mikinty/CycleSafe/README.md

# CycleSafe

A safety-system integrated onto you and your bike to keep you safe on the road.

Consists of a smart jacket that is bluetooth integrated with a bike mount.

# Bike

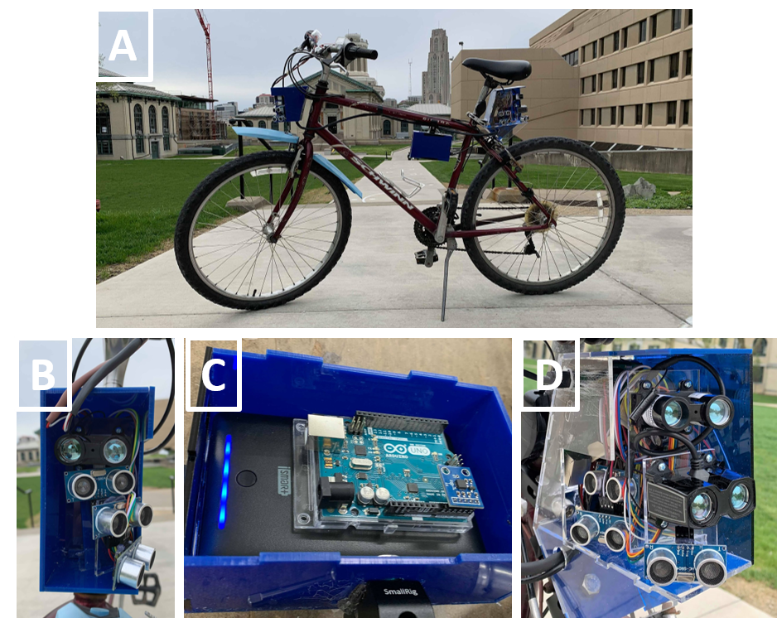
[picture p1: paper/images/bike_mount.png]
Bike Main Photo


Bike view from car
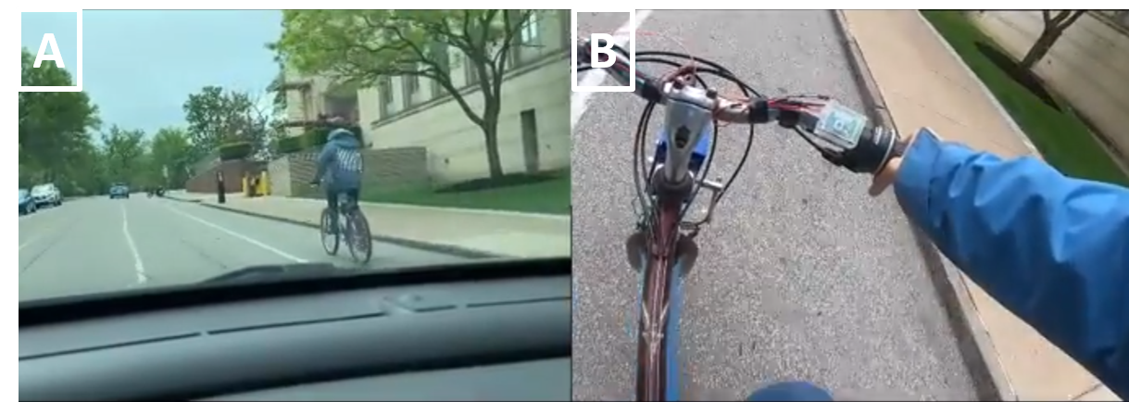
[picture p2: paper/images/side_by.png]
Bike On the Road


Bike visibility
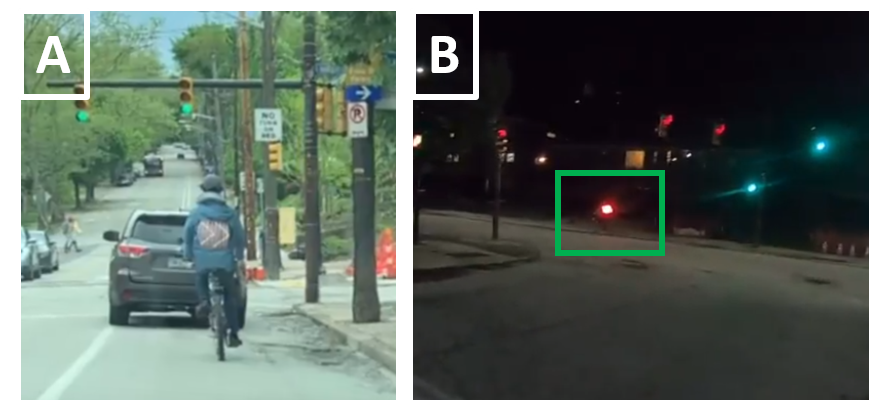
[picture p3: paper/images/visibility.png]
Bike On the Road Night


## Jacket

Chip inside the jacket
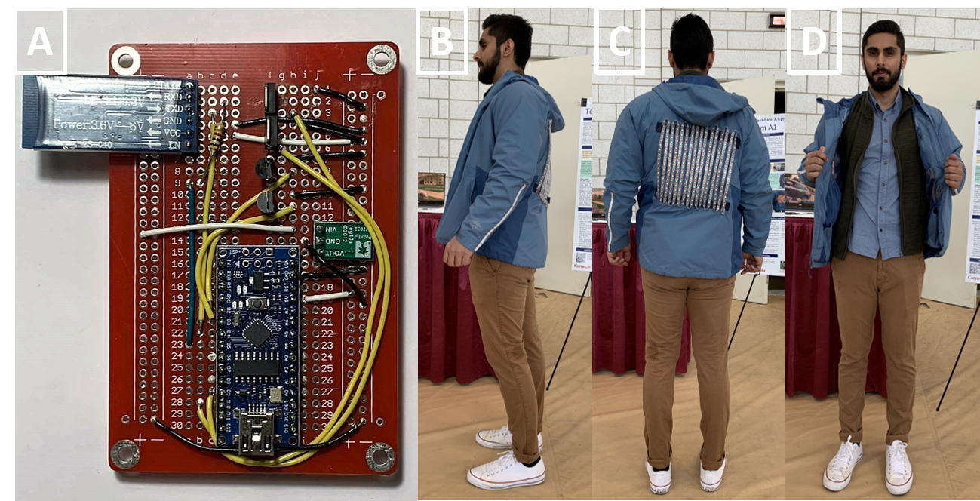
[picture p4: paper/images/jacket_chip.png]
Jacket chip


Turn Signals
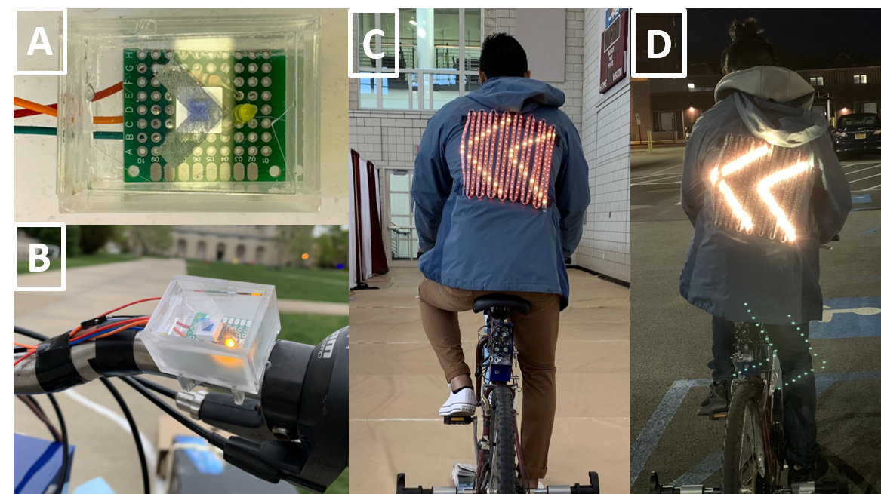
[picture p5: paper/images/turn_signals.png]
Jacket Turn Signal


Buzzer in the jacket to notify the rider
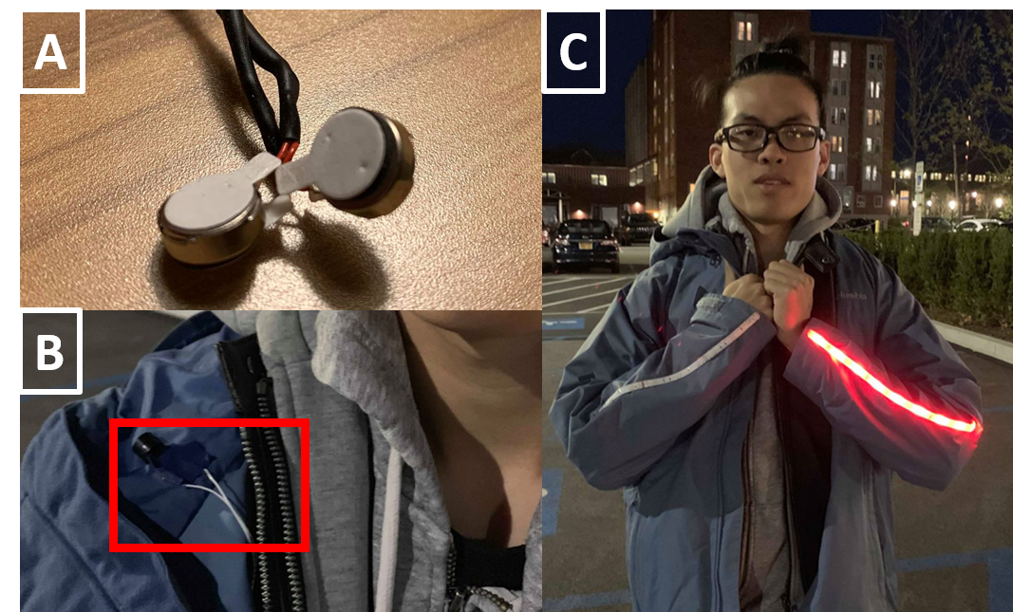
[picture p6: paper/images/buzzer_motor_prox.png]
Jacket Buzzer


## Directory Structure

- `paper`: source code for the paper
- `src`: contains all the code for the project, including

  - `arduino`: modules for the arduino, for sensor and peripheral integration
  - `android`: phone app, uses Google Map data and customizes jacket display
  - `raspberry`: code for the Raspberry Pi controller, safety sensor integration and control center for all operations
