mikinty/CycleSafe/design_review/gantt.pdf

27 | 3 | 10 | 17 | 24 | 3 | 10 | 17 | 24 | 31 | 7 | 14 | 21 | 28 | 5
1/19 | 2/19 | 3/19 | 4/19 | 5/19
CycleSafe | 0h | 50%
Foundations | 0h | 100%
Order Parts | 0 | 100%
Pi - Arduino Architecture | 0 | 100%
Android App Setup | 0 | 100%
Phone App | 0h | 48%
Intersection API Setup | 0 | 100%
Google Maps Intersection Detection | 0 | 90%
Bluetooth communication w/pi | 0 | 50%
Jacket customization settings screen | 0 | 0%
UI Design for App Interface | 0 | 0%
Raspberry Pi | 0h | 70%
Interrupt handling system | 0 | 75%
Sensor integration | 0 | 100%
Peripheral integration | 0 | 0%
Phone integration | 0 | 0%
Garmin LIDAR communication | 0 | 100%
Ultrasonic Sensor communication | 0 | 100%
Sensors | 0h | 82%
Garmin LIDAR 40m | 0 | 100%
Ultrasonic Sensor | 0 | 100%
Hall Effect/Speedometer | 0 | 100%
Equations/Specs for Safety | 0 | 100%
Bike Construction | 0 | 0%
Peripherals | 0h | 60%
16x16 LED Matrix | 0 | 75%
LED Matrix Cloth Support | 0 | 0%
Piezo Buzzers trigger | 0 | 100%
Vibration Motors trigger | 0 | 100%
Arduino Integration with Components | 0 | 100%
Arduino Bluetooth with RPi | 0 | 100%
Jacket construction with components... | 0 | 0%
Testing | 0h | 0%
Arduino Sensor Tests | 0 | 0%
Android Unit Tests | 0 | 0%
Intersection detection | 0 | 0%
Turn signal control | 0 | 0%
Collision detection | 0 | 0%
Case 1 | 0 | 0%
Case 2 | 0 | 0%
Case 3 | 0 | 0%
Architecture | 0h | 82%
Communication protocol | 0 | 50%
Component wiring design | 0 | 100%
Physical Wiring of Jacket | 0 | 100%
Git repo arch | 0 | 100%
Presentations | 0h | 27%
Proposal | 0 | 100%
Mid-Semester Review | 0 | 100%
Mid-Semester Paper | 0 | 50%
Final Poster | 0 | 0%
Demo | 0 | 0%
Final Paper | 0 | 0%
Other | 0h | 0%
Slack | 0 | 0%

Ben Huang, Michael You, Sid Lathar Ben Huang, Michael You, Sid Lathar Sid Lathar

Sid Lathar
Sid Lathar
Sid Lathar
Sid Lathar
Sid Lathar

Ben Huang
Ben Huang
Ben Huang, Michael You
Ben Huang
Ben Huang
Ben Huang

Ben Huang, Michael You
Ben Huang, Michael You
Ben Huang, Michael You
Ben Huang
Ben Huang, Michael You

Michael You
Michael You
Michael You
Michael You
Michael You
Michael You
Michael You

Michael You
Sid Lathar
Ben Huang, Michael You, Sid Lathar
Ben Huang, Michael You, Sid Lathar
Ben Huang, Michael You, Sid Lathar
Ben Huang, Michael You, Sid Lathar Ben Huang, Michael You, Sid Lathar Ben Huang, Michael You, Sid Lathar

Ben Huang, Michael You, Sid Lathar Michael You
Michael You
Michael You

Ben Huang, Michael You, Sid Lathar Ben Huang, Michael You, Sid Lathar

Ben Huang, Michael You, Sid Lathar Ben Huang, Michael You, Sid Lathar Ben Huang, Michael You, Sid Lathar

Ben Huang, Michael You, Sid Lathar

Powered by TCPDF (www.tcpdf.org)
