mikinty/CycleSafe/design_review/preamble.tex

%% Packages for paper
\usepackage{cite}

% *** GRAPHICS RELATED PACKAGES ***
\usepackage[pdftex]{graphicx}
\graphicspath{{images/}}
\DeclareGraphicsExtensions{.pdf,.jpeg,.png}
\usepackage{tikz}
\usepackage[american voltages, arrowmos]{circuitikz}
\usetikzlibrary{math}

% *** MATH PACKAGES ***
\usepackage{amsmath}
\usepackage{physics}
\usepackage{siunitx}

% *** SPECIALIZED LIST PACKAGES ***
\usepackage{algorithmic}

% *** SUBFIGURE PACKAGES ***
\usepackage[caption=false,font=footnotesize]{subfig}

% *** FLOAT PACKAGES ***
\usepackage{float}
%\usepackage{fixltx2e}
% fixltx2e, the successor to the earlier fix2col.sty, was written by
% Frank Mittelbach and David Carlisle. This package corrects a few problems
% in the LaTeX2e kernel, the most notable of which is that in current
% LaTeX2e releases, the ordering of single and double column floats is not
% guaranteed to be preserved. Thus, an unpatched LaTeX2e can allow a
% single column figure to be placed prior to an earlier double column
% figure.
% Be aware that LaTeX2e kernels dated 2015 and later have fixltx2e.sty's
% corrections already built into the system in which case a warning will
% be issued if an attempt is made to load fixltx2e.sty as it is no longer
% needed.
% The latest version and documentation can be found at:
% http://www.ctan.org/pkg/fixltx2e

%\usepackage{stfloats}
% stfloats.sty was written by Sigitas Tolusis. This package gives LaTeX2e
% the ability to do double column floats at the bottom of the page as well
% as the top. (e.g., "\begin{figure*}[!b]" is not normally possible in
% LaTeX2e). It also provides a command:
%\fnbelowfloat
% to enable the placement of footnotes below bottom floats (the standard
% LaTeX2e kernel puts them above bottom floats). This is an invasive package
% which rewrites many portions of the LaTeX2e float routines. It may not work
% with other packages that modify the LaTeX2e float routines. The latest
% version and documentation can be obtained at:
% http://www.ctan.org/pkg/stfloats
% Do not use the stfloats baselinefloat ability as the IEEE does not allow
% \baselineskip to stretch. Authors submitting work to the IEEE should note
% that the IEEE rarely uses double column equations and that authors should try
% to avoid such use. Do not be tempted to use the cuted.sty or midfloat.sty
% packages (also by Sigitas Tolusis) as the IEEE does not format its papers in
% such ways.
% Do not attempt to use stfloats with fixltx2e as they are incompatible.
% Instead, use Morten Hogholm'a dblfloatfix which combines the features
% of both fixltx2e and stfloats:
%
% \usepackage{dblfloatfix}
% The latest version can be found at:
% http://www.ctan.org/pkg/dblfloatfix

%\ifCLASSOPTIONcaptionsoff
%  \usepackage[nomarkers]{endfloat}
% \let\MYoriglatexcaption\caption
% \renewcommand{\caption}[2][\relax]{\MYoriglatexcaption[#2]{#2}}
%\fi
% endfloat.sty was written by James Darrell McCauley, Jeff Goldberg and 
% Axel Sommerfeldt. This package may be useful when used in conjunction with 
% IEEEtran.cls'  captionsoff option. Some IEEE journals/societies require that
% submissions have lists of figures/tables at the end of the paper and that
% figures/tables without any captions are placed on a page by themselves at
% the end of the document. If needed, the draftcls IEEEtran class option or
% \CLASSINPUTbaselinestretch interface can be used to increase the line
% spacing as well. Be sure and use the nomarkers option of endfloat to
% prevent endfloat from "marking" where the figures would have been placed
% in the text. The two hack lines of code above are a slight modification of
% that suggested by in the endfloat docs (section 8.4.1) to ensure that
% the full captions always appear in the list of figures/tables - even if
% the user used the short optional argument of \caption[]{}.
% IEEE papers do not typically make use of \caption[]'s optional argument,
% so this should not be an issue. A similar trick can be used to disable
% captions of packages such as subfig.sty that lack options to turn off
% the subcaptions:
% For subfig.sty:
% \let\MYorigsubfloat\subfloat
% \renewcommand{\subfloat}[2][\relax]{\MYorigsubfloat[]{#2}}
% However, the above trick will not work if both optional arguments of
% the \subfloat command are used. Furthermore, there needs to be a
% description of each subfigure *somewhere* and endfloat does not add
% subfigure captions to its list of figures. Thus, the best approach is to
% avoid the use of subfigure captions (many IEEE journals avoid them anyway)
% and instead reference/explain all the subfigures within the main caption.
% The latest version of endfloat.sty and its documentation can obtained at:
% http://www.ctan.org/pkg/endfloat
%
% The IEEEtran \ifCLASSOPTIONcaptionsoff conditional can also be used
% later in the document, say, to conditionally put the References on a 
% page by themselves.

% *** PDF, URL AND HYPERLINK PACKAGES ***
\usepackage{url}
\usepackage{hyperref}
\hypersetup{
    urlcolor=blue
}

% *** OTHER PACKAGESS ***
\usepackage{booktabs} % for \toprule, \midrule, etc
\usepackage{tabularx}
\usepackage{pdfpages}

% correct bad hyphenation here
\hyphenation{op-tical net-works semi-conduc-tor}

%% Shortcuts
\newcommand{\slane}{s_\text{lane}}
\newcommand{\sbrake}{s_\text{brake}}
\newcommand{\lidar}{Garmin LIDAR-Lite v3}
\newcommand{\sonar}{HC-SR04}

%% Custom config
\DeclareSIUnit{\mph}{mph}
\DeclareSIUnit\lb{lb}
\sisetup{detect-all} % Use the environment font when calling siunitx
