mikinty/CycleSafe/design_review/images/speedometer.png

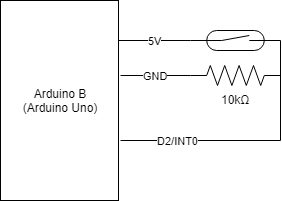
design_review/images/speedometer.png
