mikinty/CycleSafe/paper/images/BS_Overall.PNG

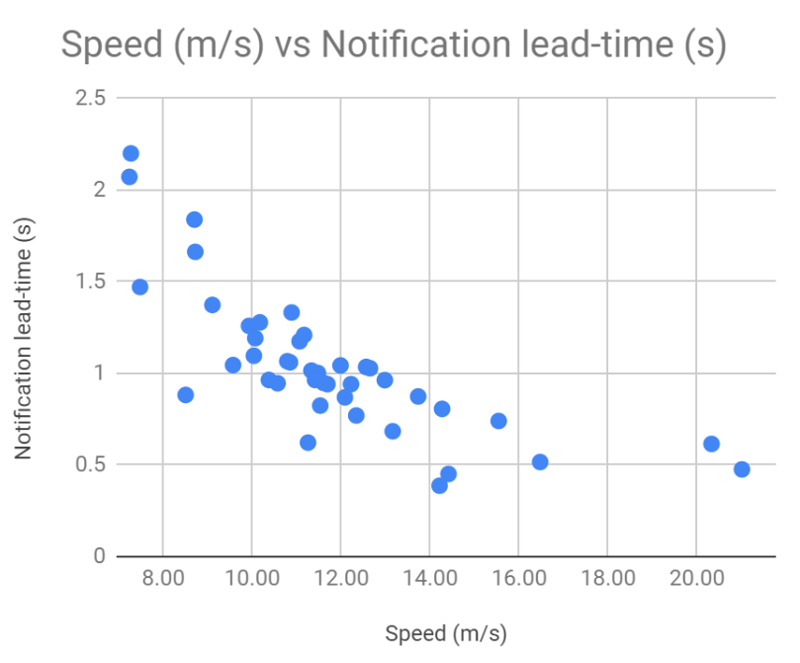
paper/images/BS_Overall.PNG
