mikinty/CycleSafe/models/side_assembly.SLDASM

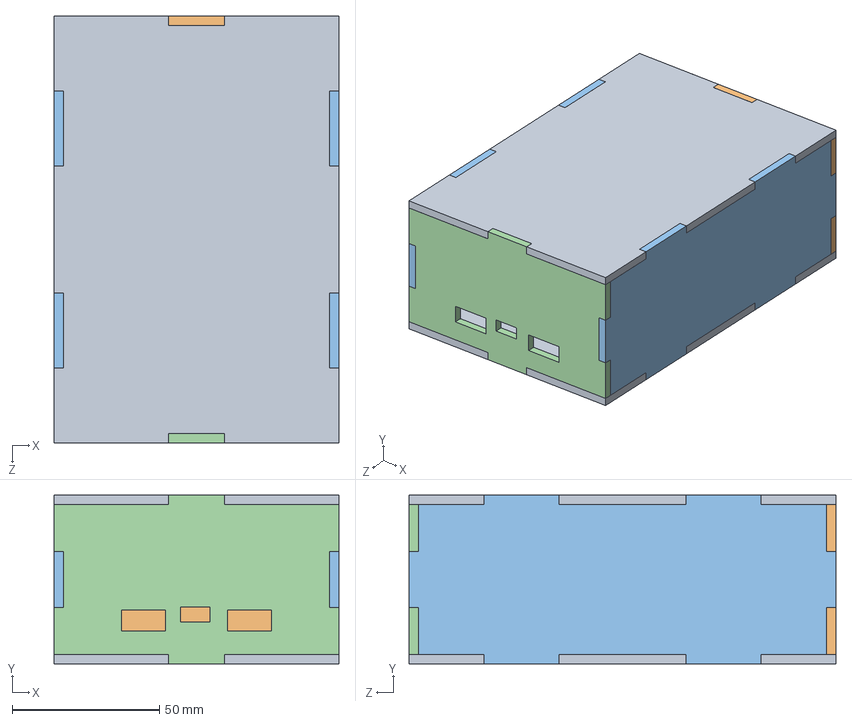
[picture p21: CAD file, 2019-05-08]
models/side_assembly.SLDASM
96.5 x 57.2 x 144.8 mm
battery_mount_base x 2
battery_mount_side
battery_mount_side_long x 2
battery_mount_side_front
