mikinty/CycleSafe/models/back_assembly.SLDASM

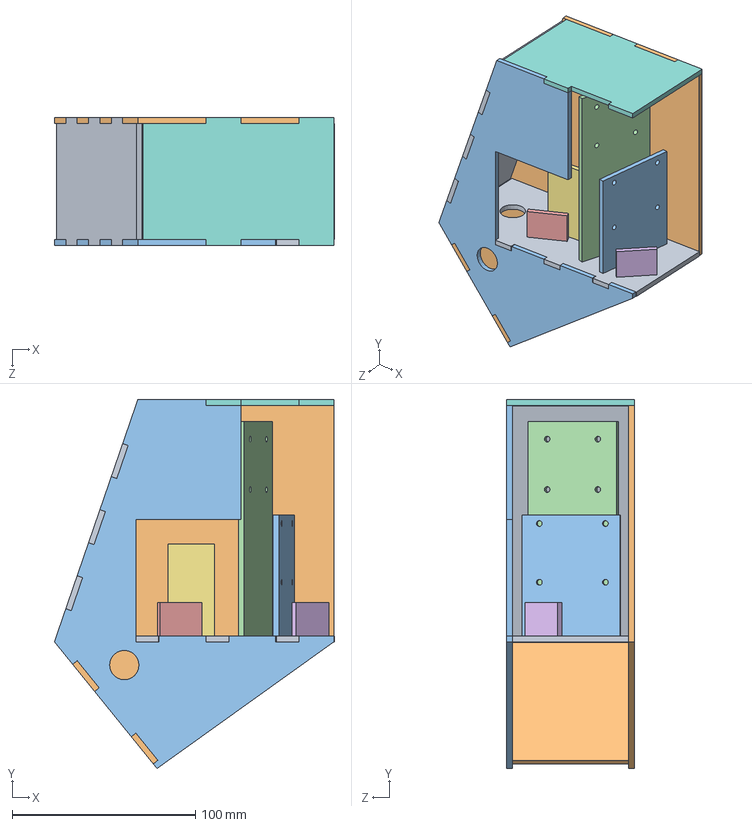
[picture p22: CAD file, 2019-05-08]
models/back_assembly.SLDASM
152.8 x 201.2 x 69.8 mm
back_mount_base
back_mount_cover_back
lidar_back_straight
lidar_back_slant
ultrasound_back_medium
ultrasound_back_short
ultrasound_back_tall
back_mount_roof
back_mount_cover_slant_top
back_mount_cover_slant_bot
back_mount_cover_front
