mikinty/CycleSafe/models/front_assembly.SLDASM

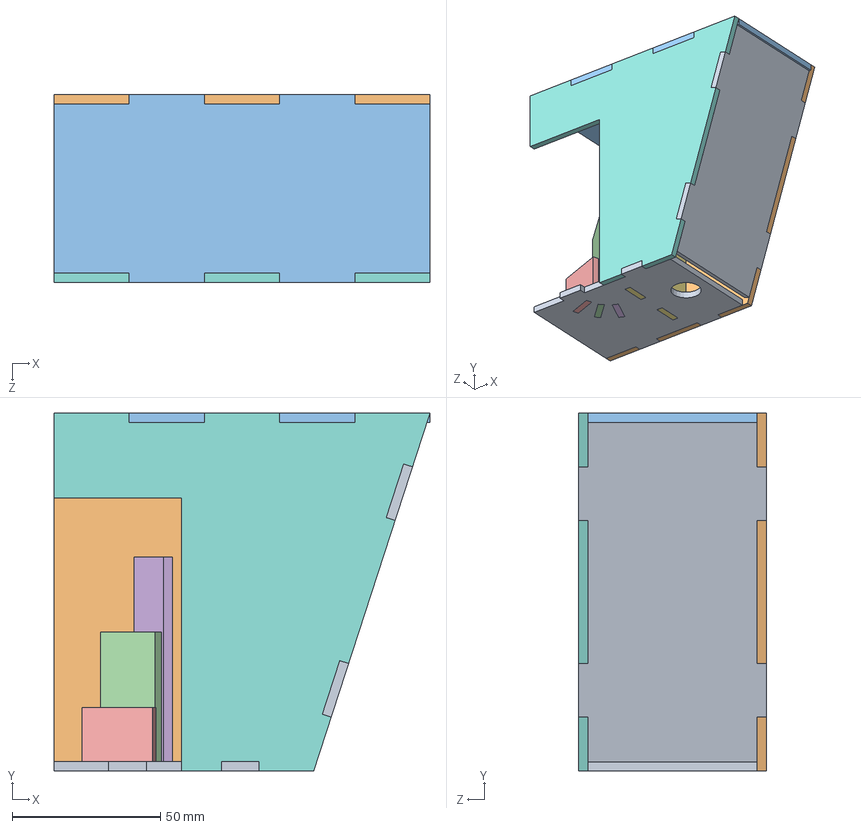
[picture p23: CAD file, 2019-05-08]
models/front_assembly.SLDASM
127.0 x 120.8 x 63.5 mm
front_mount_base
front_mount_cover
front_mount_roof
ultrasound_front_medium
ultrasound_front_short
ultrasound_front_tall
lidar_front
front_mount_cover_front
front_mount_cover_back
