mikinty/CycleSafe/models/turn_sig_assembly.SLDASM

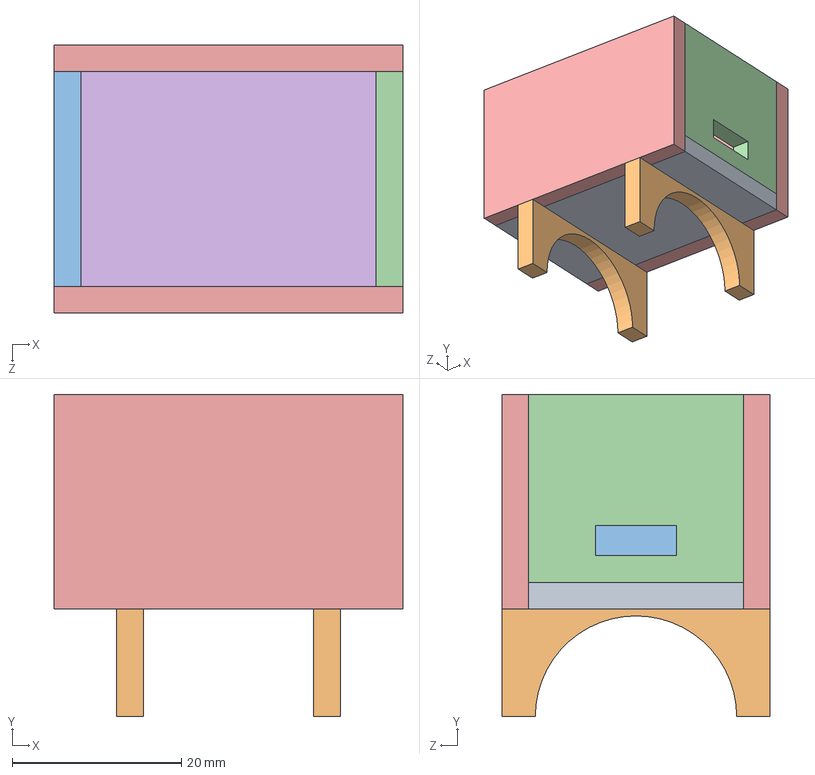
[picture p24: CAD file, 2019-05-08]
models/turn_sig_assembly.SLDASM
41.3 x 38.1 x 31.8 mm
turn_sig_bottom
turn_sig_arch x 2
turn_sig_back
turn_sig_front
turn_sig_side x 2
turn_sig_top
