mikinty/CycleSafe/models/lidar_back_slant.SLDPRT

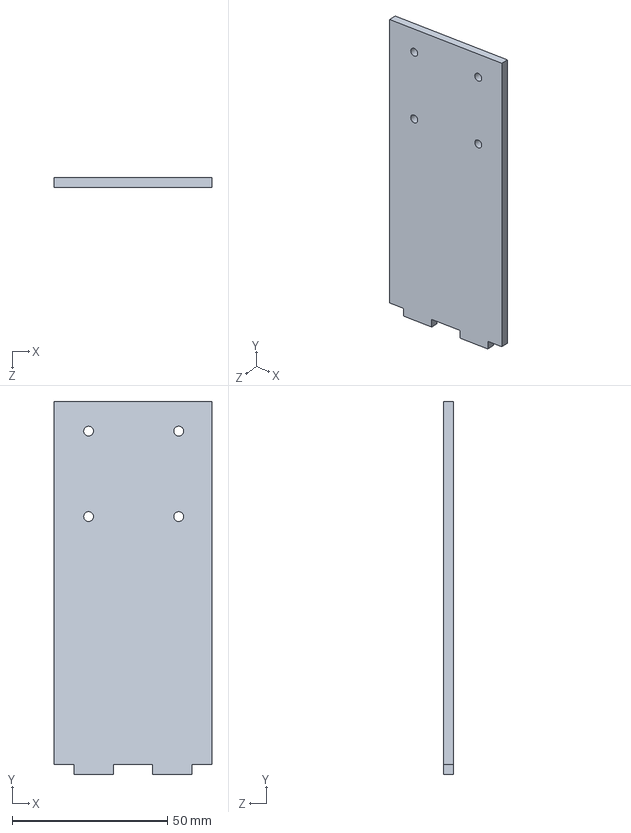
[picture p25: CAD file, 2019-05-08]
models/lidar_back_slant.SLDPRT
50.8 x 120.0 x 3.17 mm
