mikinty/CycleSafe/models/ultrasound_back_medium.SLDPRT

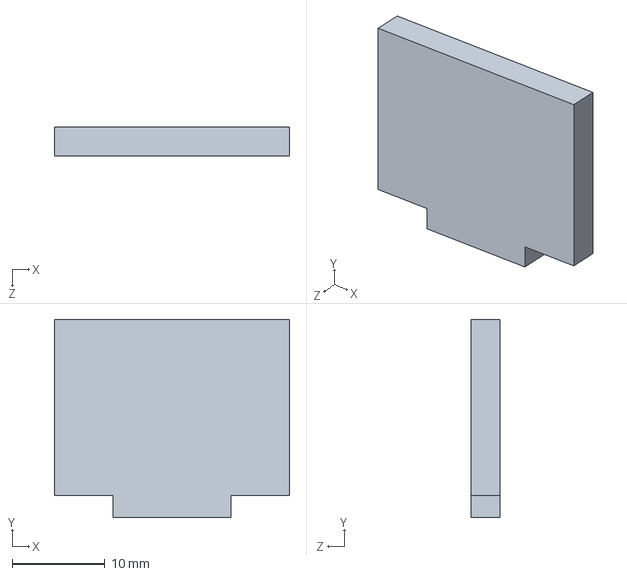
[picture p26: CAD file, 2019-05-08]
models/ultrasound_back_medium.SLDPRT
25.4 x 21.4 x 3.17 mm
