mikinty/CycleSafe/models/ultrasound_front_medium.SLDPRT

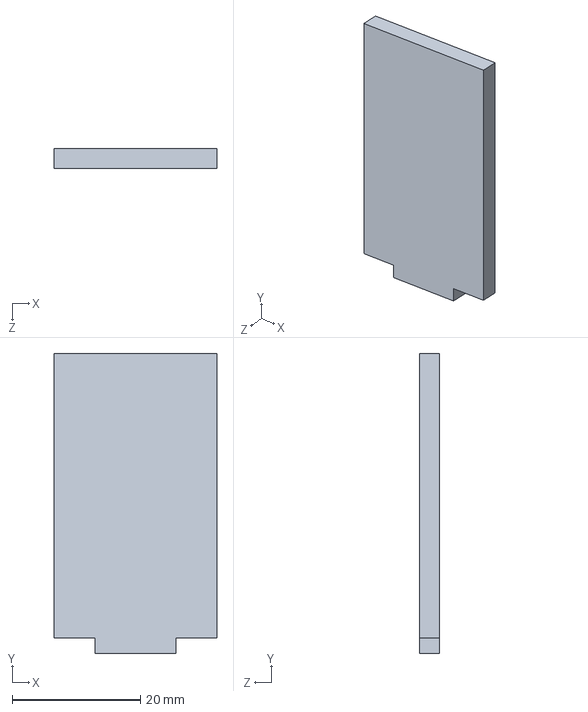
[picture p27: CAD file, 2019-05-08]
models/ultrasound_front_medium.SLDPRT
25.4 x 46.8 x 3.17 mm
