mikinty/CycleSafe/models/front_mount_cover.SLDPRT

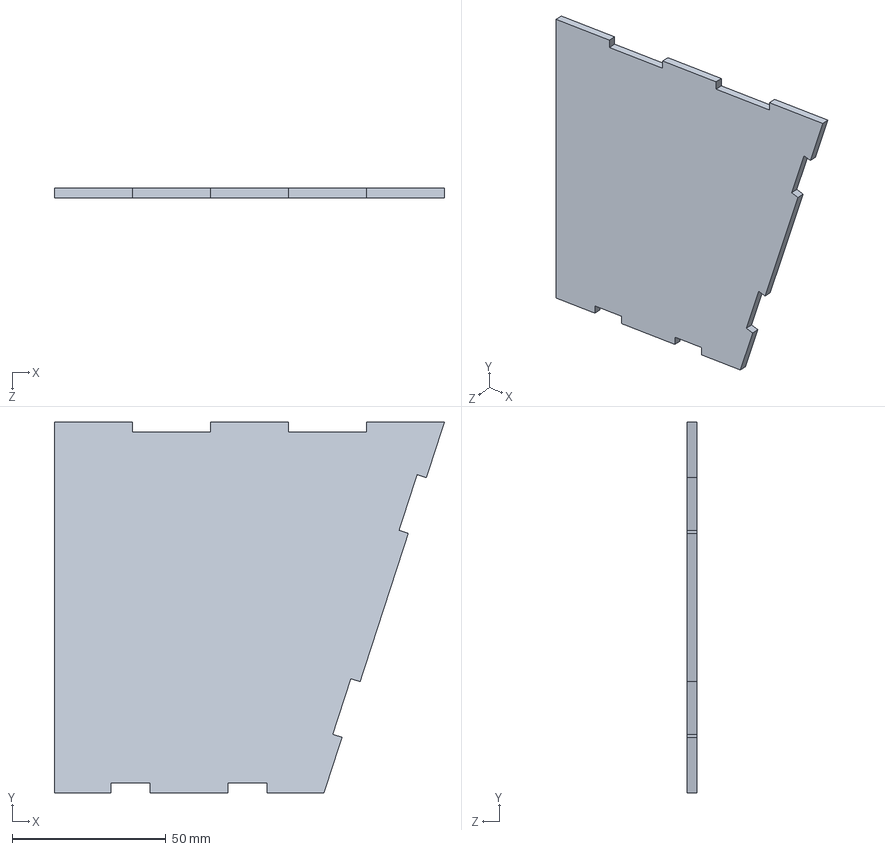
[picture p28: CAD file, 2019-05-08]
models/front_mount_cover.SLDPRT
127.0 x 120.8 x 3.17 mm
