mikinty/CycleSafe/models/lidar_back_straight.SLDPRT

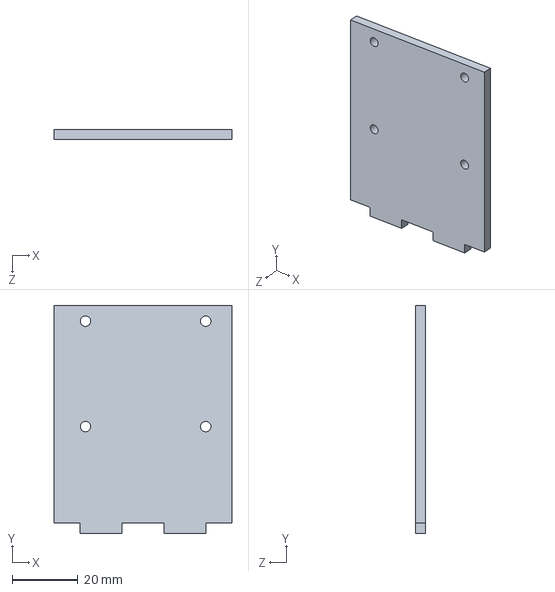
[picture p29: CAD file, 2019-05-08]
models/lidar_back_straight.SLDPRT
54.0 x 69.2 x 3.17 mm
