mikinty/CycleSafe/models/ultrasound_front_tall.SLDPRT

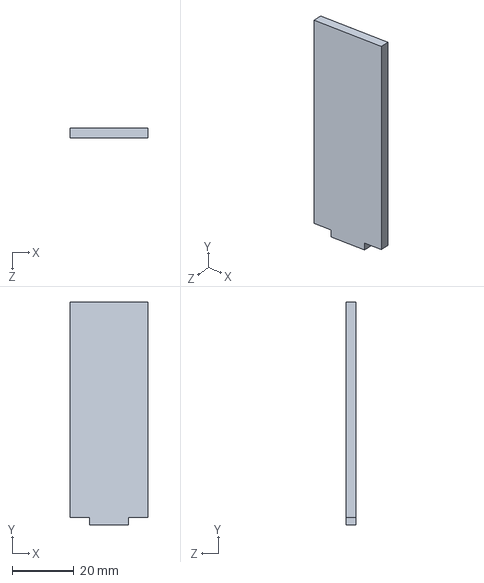
[picture p30: CAD file, 2019-05-08]
models/ultrasound_front_tall.SLDPRT
25.4 x 72.2 x 3.17 mm
