mikinty/CycleSafe/models/turn_sig_front.SLDPRT

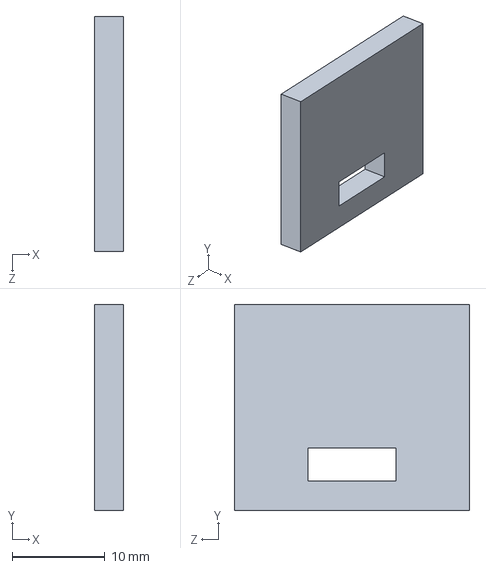
[picture p31: CAD file, 2019-05-08]
models/turn_sig_front.SLDPRT
3.17 x 22.2 x 25.4 mm
