mikinty/CycleSafe/models/turn_sig_bottom.SLDPRT

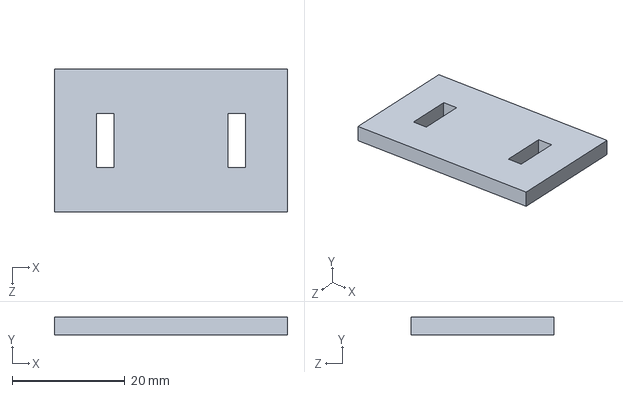
[picture p32: CAD file, 2019-05-08]
models/turn_sig_bottom.SLDPRT
41.3 x 3.17 x 25.4 mm
