mikinty/CycleSafe/models/back_mount_cover_slant_bot.SLDPRT

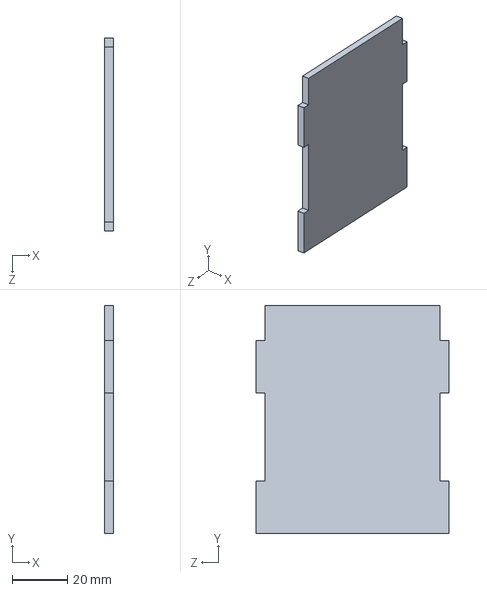
[picture p33: CAD file, 2019-05-08]
models/back_mount_cover_slant_bot.SLDPRT
3.17 x 82.5 x 69.8 mm
