mikinty/CycleSafe/models/turn_sig_side.SLDPRT

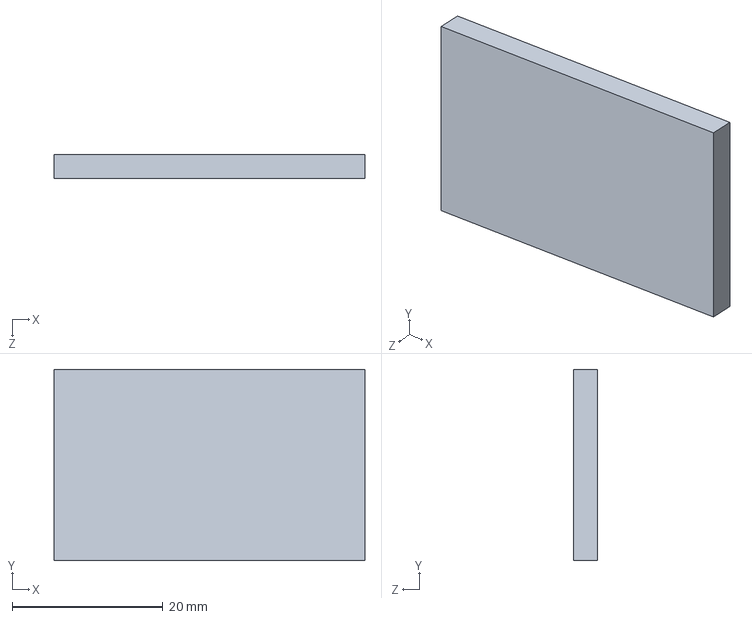
[picture p34: CAD file, 2019-05-08]
models/turn_sig_side.SLDPRT
41.3 x 25.4 x 3.17 mm
