mikinty/CycleSafe/models/front_mount_cover_front.SLDPRT

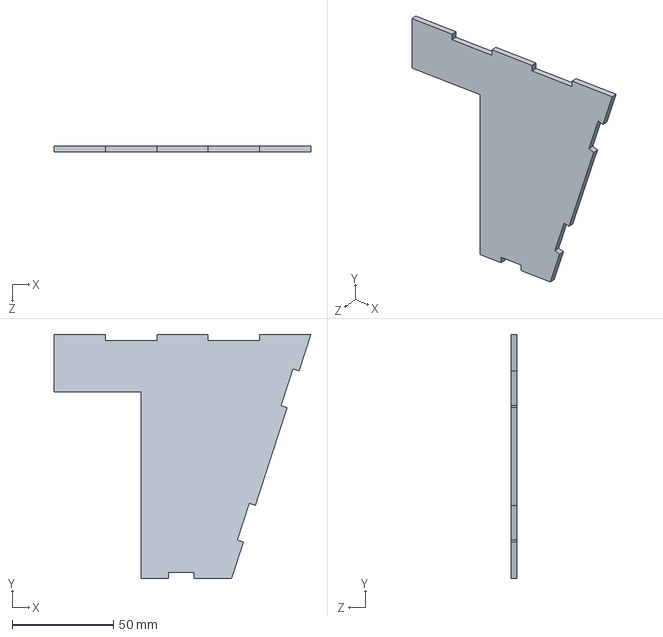
[picture p35: CAD file, 2019-05-08]
models/front_mount_cover_front.SLDPRT
127.0 x 120.8 x 3.17 mm
