mikinty/CycleSafe/models/back_mount_cover_front.SLDPRT

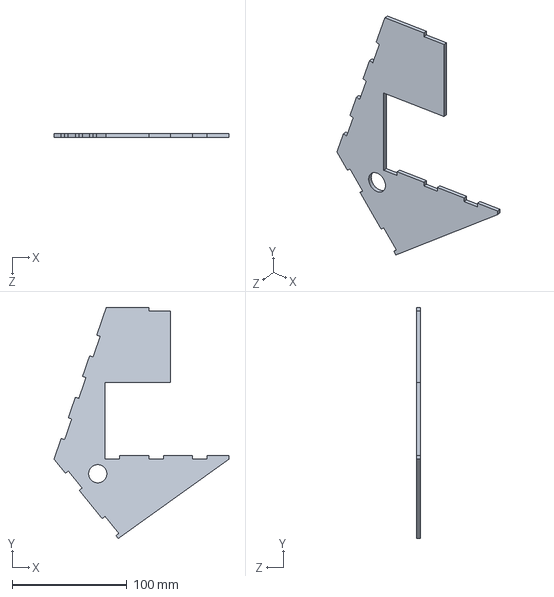
[picture p36: CAD file, 2019-05-08]
models/back_mount_cover_front.SLDPRT
152.4 x 201.2 x 3.17 mm
