mikinty/CycleSafe/models/back_mount_base.SLDPRT

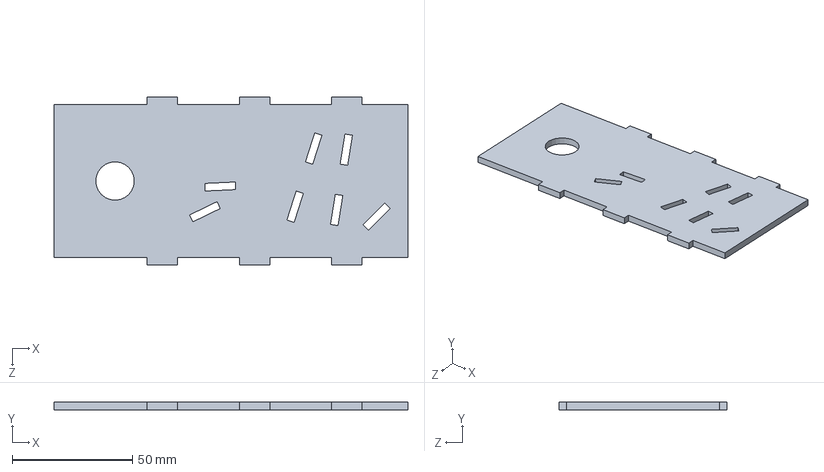
[picture p37: CAD file, 2019-05-08]
models/back_mount_base.SLDPRT
147.3 x 3.17 x 69.8 mm
