mikinty/CycleSafe/models/front_mount_base.SLDPRT

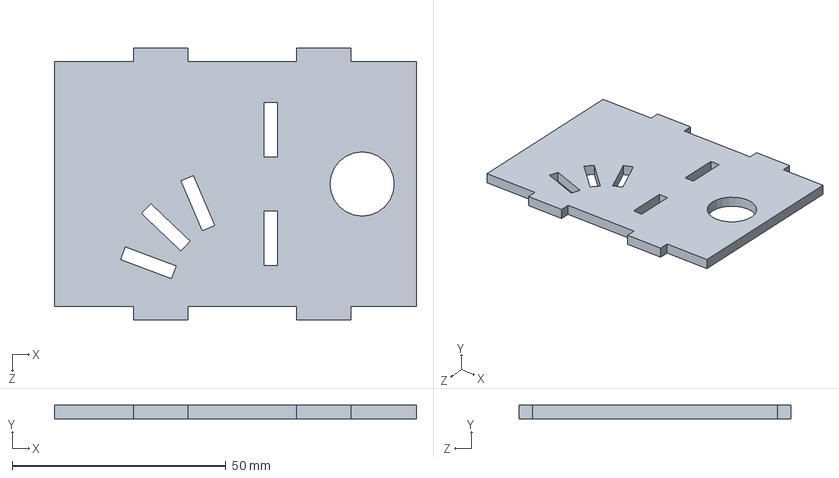
[picture p38: CAD file, 2019-05-08]
models/front_mount_base.SLDPRT
84.6 x 3.17 x 63.5 mm
