mikinty/CycleSafe/models/front_mount_roof.SLDPRT

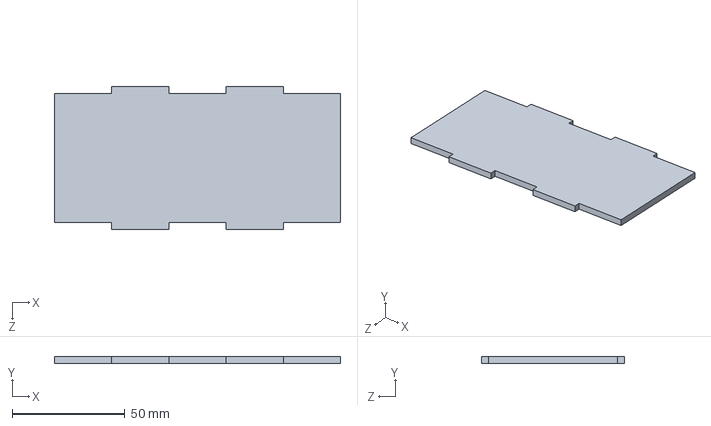
[picture p39: CAD file, 2019-05-08]
models/front_mount_roof.SLDPRT
127.0 x 3.17 x 63.5 mm
