mikinty/CycleSafe/models/back_mount_roof.SLDPRT

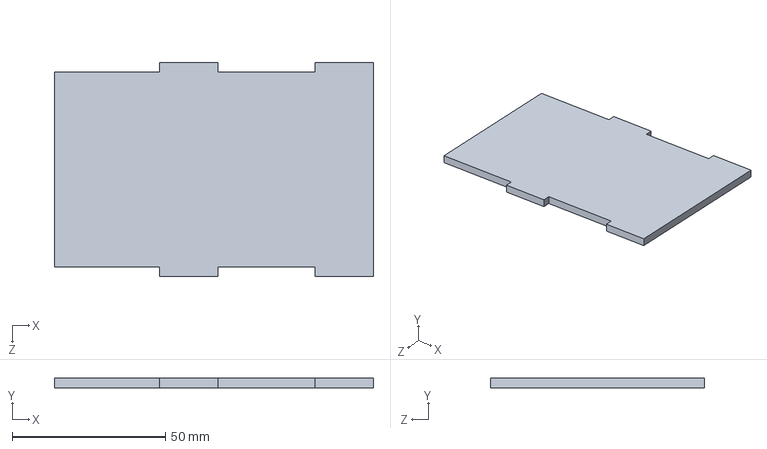
[picture p40: CAD file, 2019-05-08]
models/back_mount_roof.SLDPRT
104.1 x 3.17 x 69.8 mm
