mikinty/CycleSafe/models/battery_mount_side_long.SLDPRT

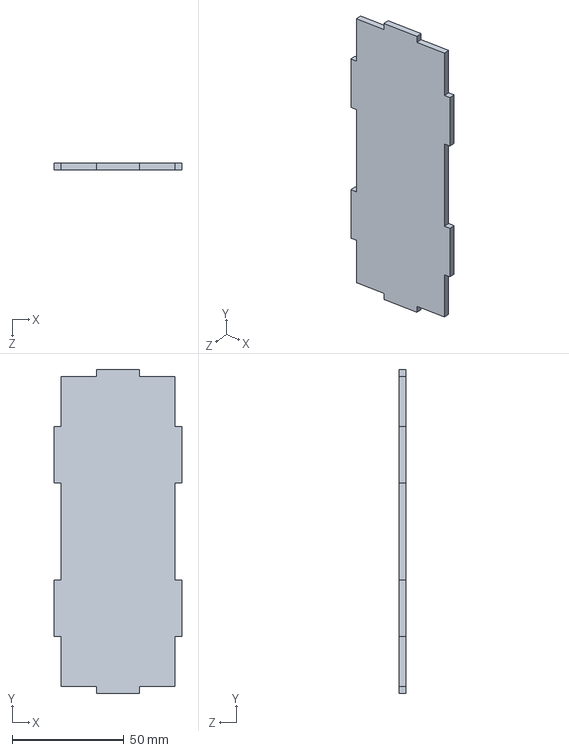
[picture p41: CAD file, 2019-05-08]
models/battery_mount_side_long.SLDPRT
57.2 x 144.8 x 3.17 mm
