mikinty/CycleSafe/models/battery_mount_side.SLDPRT

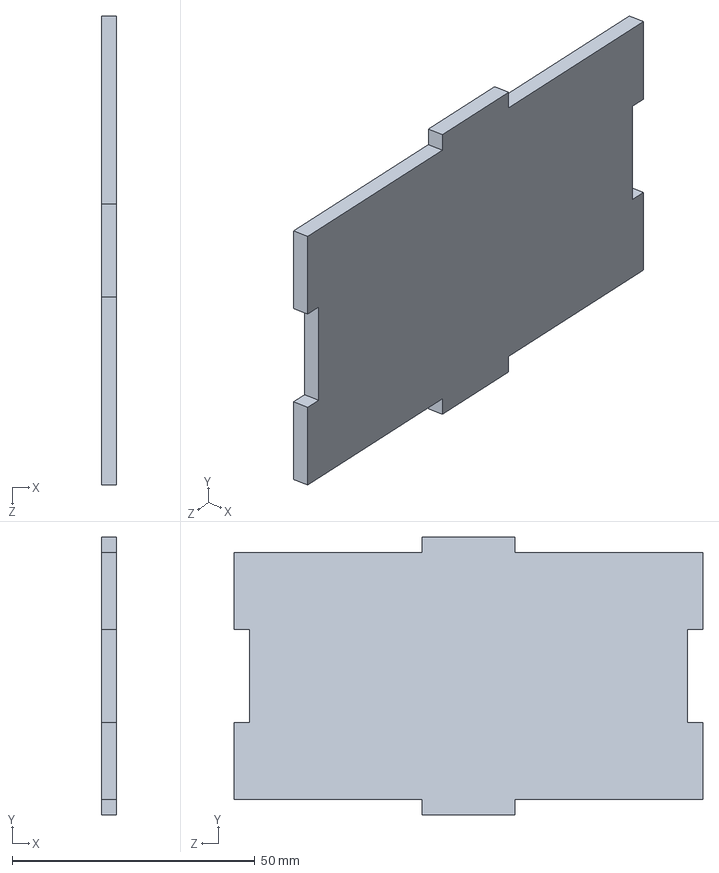
[picture p42: CAD file, 2019-05-08]
models/battery_mount_side.SLDPRT
3.17 x 57.2 x 96.5 mm
