mikinty/CycleSafe/models/ultrasound_back_tall.SLDPRT

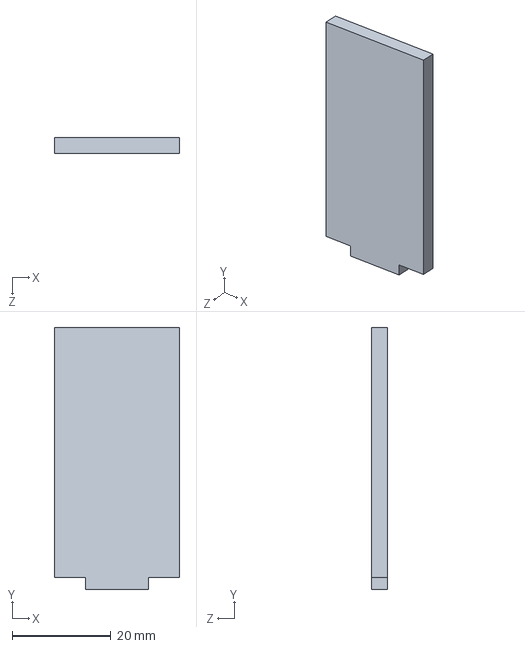
[picture p43: CAD file, 2019-05-08]
models/ultrasound_back_tall.SLDPRT
25.4 x 53.2 x 3.17 mm
