mikinty/CycleSafe/models/battery_mount_base.SLDPRT

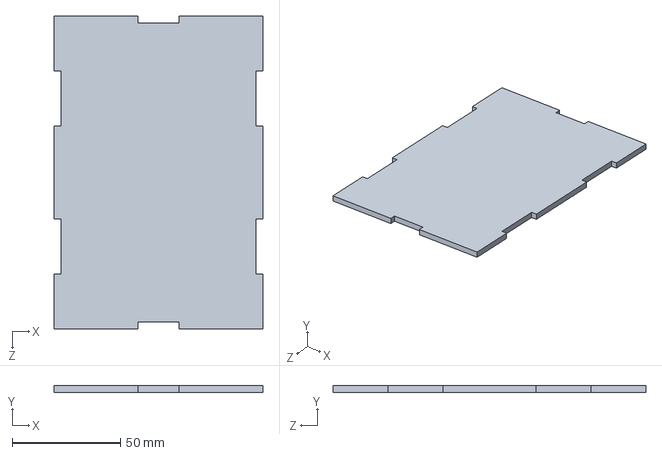
[picture p44: CAD file, 2019-05-08]
models/battery_mount_base.SLDPRT
96.5 x 3.17 x 144.8 mm
