mikinty/CycleSafe/models/front_mount_cover_back.SLDPRT

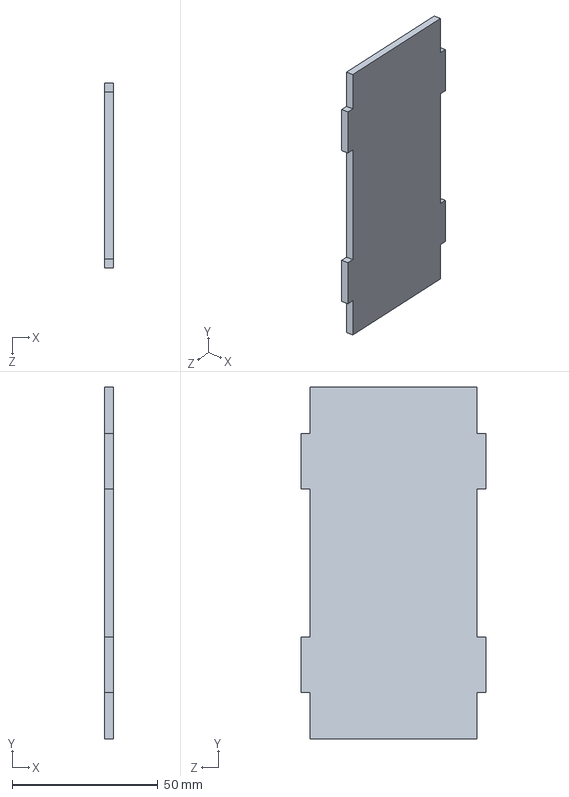
[picture p45: CAD file, 2019-05-08]
models/front_mount_cover_back.SLDPRT
3.17 x 120.7 x 63.5 mm
