mikinty/CycleSafe/models/turn_sig_arch.SLDPRT

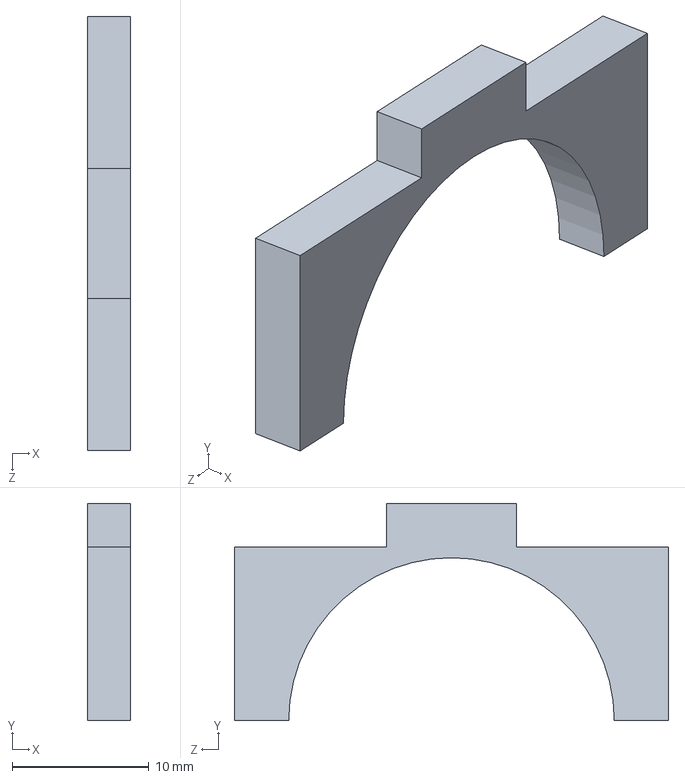
[picture p46: CAD file, 2019-05-08]
models/turn_sig_arch.SLDPRT
3.17 x 15.9 x 31.8 mm
