mikinty/CycleSafe/models/turn_sig_top.SLDPRT

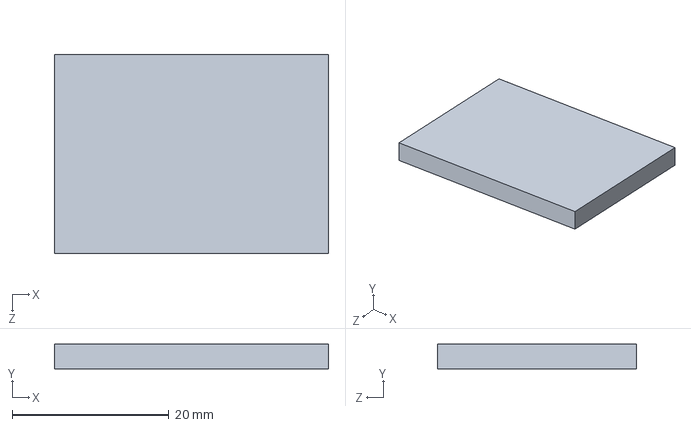
[picture p47: CAD file, 2019-05-08]
models/turn_sig_top.SLDPRT
34.9 x 3.17 x 25.4 mm
