mikinty/CycleSafe/models/lidar_front.SLDPRT

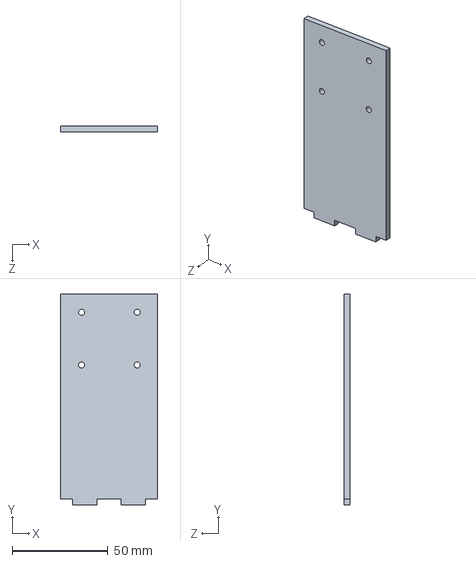
[picture p48: CAD file, 2019-05-08]
models/lidar_front.SLDPRT
50.8 x 110.1 x 3.17 mm
