mikinty/CycleSafe/models/back_mount_cover_slant_top.SLDPRT

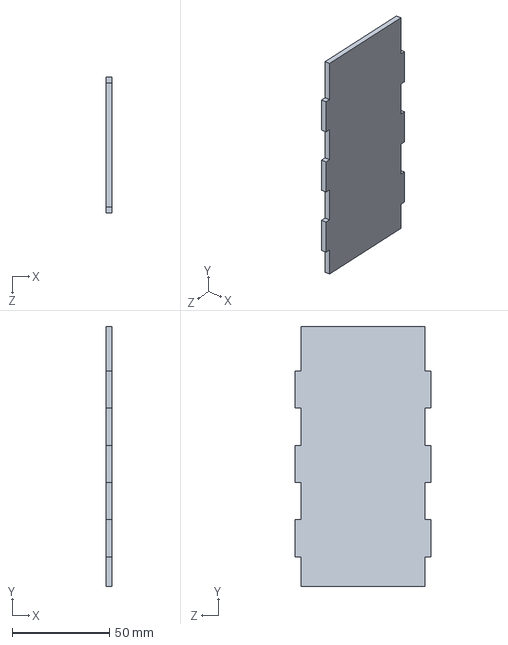
[picture p50: CAD file, 2019-05-08]
models/back_mount_cover_slant_top.SLDPRT
3.17 x 133.4 x 69.8 mm
