mikinty/CycleSafe/(list of files, cad)

Other CAD files:
models/ultrasound_front_short.SLDPRT
models/ultrasound_back_short.SLDPRT
models/turn_sig_back.SLDPRT
models/battery_mount_side_front.SLDPRT
models/back_mount_drawing.SLDDRW
models/battery_mount_drawing.SLDDRW
models/front_mount_drawing.SLDDRW
models/turn_sig_no_top_drawing.SLDDRW
models/turn_sig_top_drawing.SLDDRW
