mikinty/CycleSafe/(commit log)

2019-02-20 some pi/arduino tests
2019-02-25 LIDAR tests
2019-03-18 added directory arduino
2019-03-27 lidar, other changes
2019-03-27 bt tests, lidar test works
2019-03-29 jacket bt test good, lidar test good
2019-04-03 led test
2019-04-03 demo for jacket. Supports LED matrix, vibration motors, piezo buzzers
    [jacket_controls.ino, jacket_protocol.h]
2019-04-17 lidar stuff
2019-04-17 fixed lidar
2019-04-19 pin num
2019-04-28 solidworks models for project
    [back_assembly.SLDASM, back_mount_base.SLDPRT, back_mount_cover_back.SLDPRT, back_mount_cover_front.SLDPRT, back_mount_cover_slant_bot.SLDPRT, back_mount_cover_slant_top.SLDPRT, back_mount_drawing.SLDDRW, back_mount_roof.SLDPRT]
2019-05-03 added UI printers
